PixelisedShark/WROFutureEngineers2024/v-photos/car_bottom.jpg

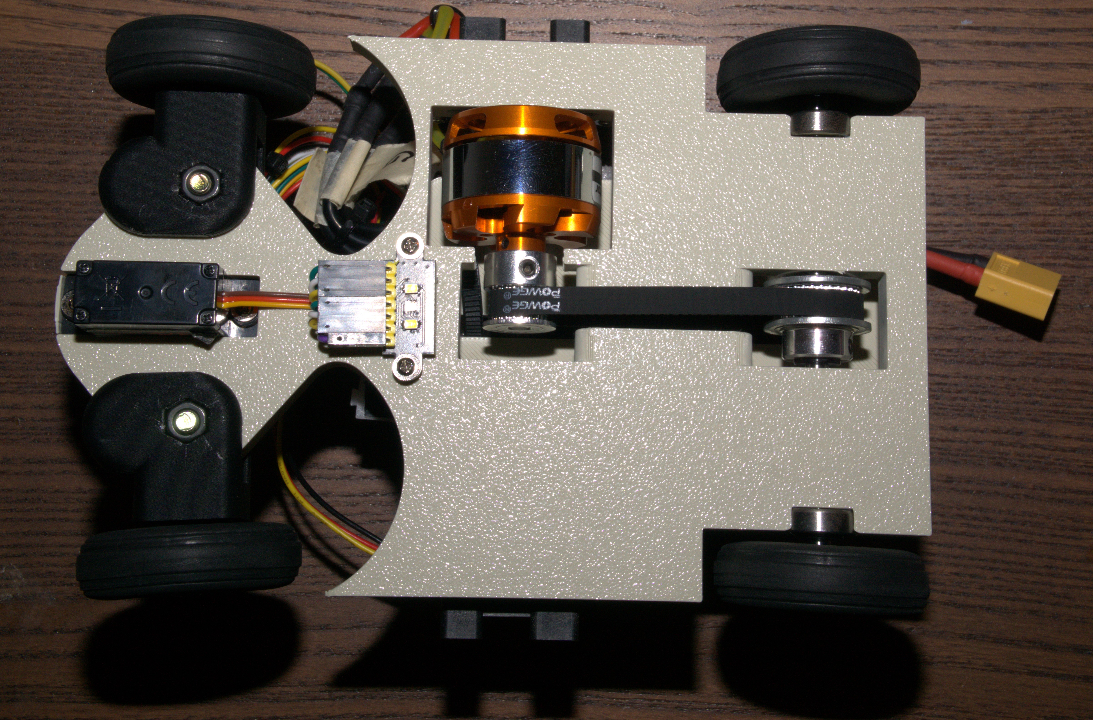
v-photos/car_bottom.jpg
