PixelisedShark/WROFutureEngineers2024/v-photos/car_side2.jpg

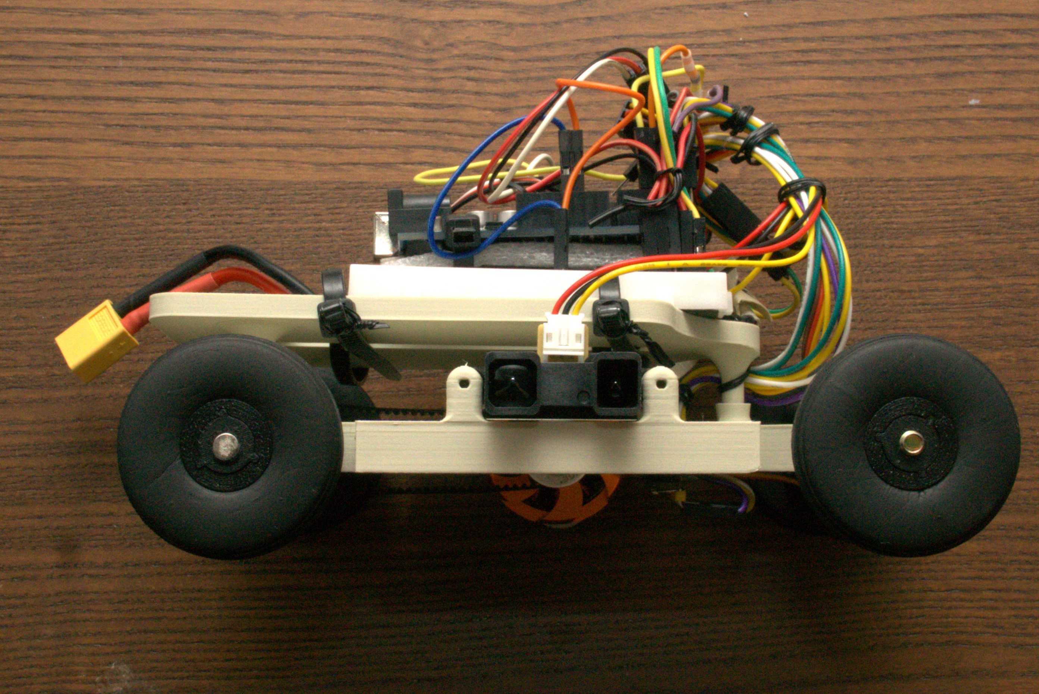
v-photos/car_side2.jpg
