PixelisedShark/WROFutureEngineers2024/README.md

Engineering materials
====

This repository contains engineering materials of a self-driven vehicle's model participating in the WRO Future Engineers competition in the season 2024.

## Content

* `t-photos` contains 2 photos of the team (an official one and one funny photo with all team members)
* `v-photos` contains 6 photos of the vehicle (from every side, from top and bottom)
* `video` contains the video.md file with the link to a video where driving demonstration exists
* `schemes` contains one or several schematic diagrams in form of JPEG, PNG or PDF of the electromechanical components illustrating all the elements (electronic components and motors) used in the vehicle and how they connect to each other.
* `src` contains code of control software for all components which were programmed to participate in the competition
* `models` is for the files for models used by 3D printers, laser cutting machines and CNC machines to produce the vehicle elements. If there is nothing to add to this location, the directory can be removed.
* `other` is for other files which can be used to understand how to prepare the vehicle for the competition. It may include documentation how to connect to a SBC/SBM and upload files there, datasets, hardware specifications, communication protocols descriptions etc. If there is nothing to add to this location, the directory can be removed.

## Introduction

Group Members:
Jing Wei (builder)
Chandler (coder)
Dhevash (coder)

Hello, Viewer!

We are a group of students from Yuan Ching Secondary School. This repository contains a collection of our work from the past year. All models and files here are open source, so you’re welcome to use them as inspiration, adapt them to your needs, or enhance them further.

We hope that by sharing our work, we can contribute to the broader community and assist others in their projects.

Happy exploring!

Electronics used
   *husky lense
   *brushless DC motor
   *Sharp IR sensors
   *Colour Sensor 
   *servo

Documentation of building, prototyping and assembly is under other files. complied as a PDF
