PixelisedShark/WROFutureEngineers2024/v-photos/car_front.jpg

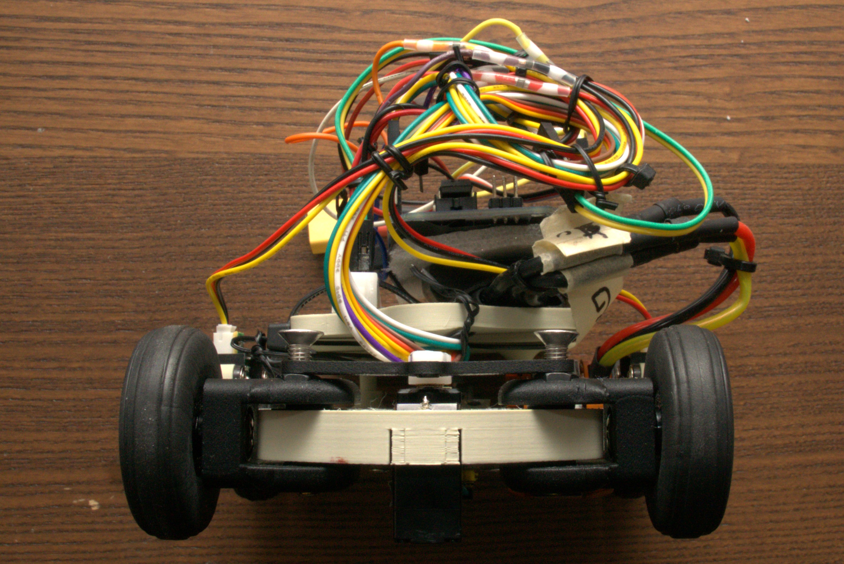
v-photos/car_front.jpg
