PixelisedShark/WROFutureEngineers2024/v-photos/car_side1.jpg

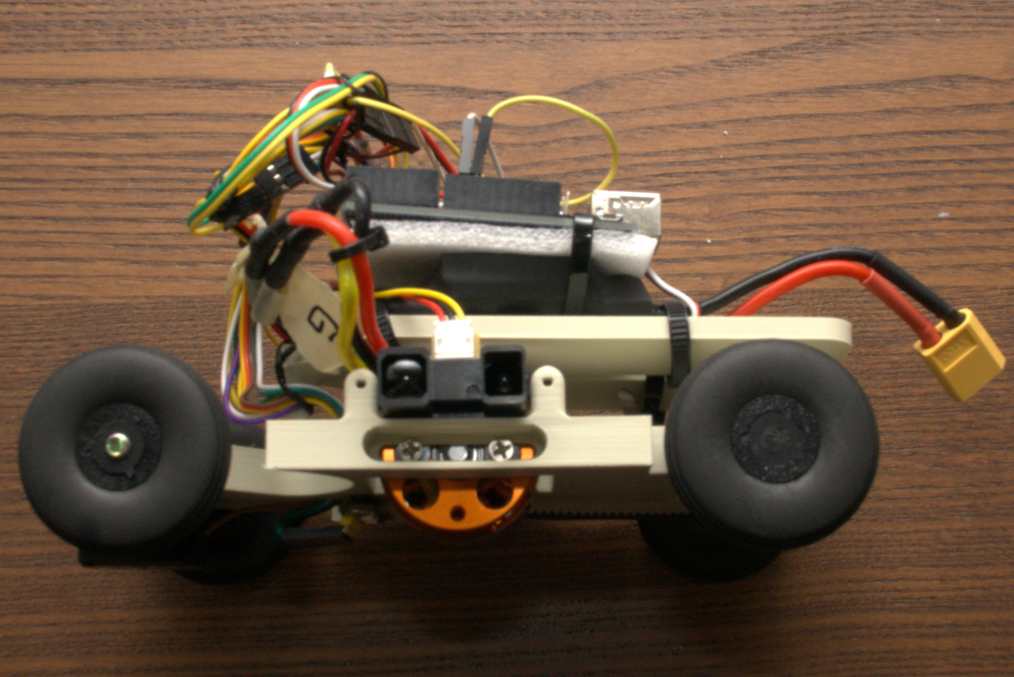
v-photos/car_side1.jpg
