PixelisedShark/WROFutureEngineers2024/v-photos/car_top.jpg

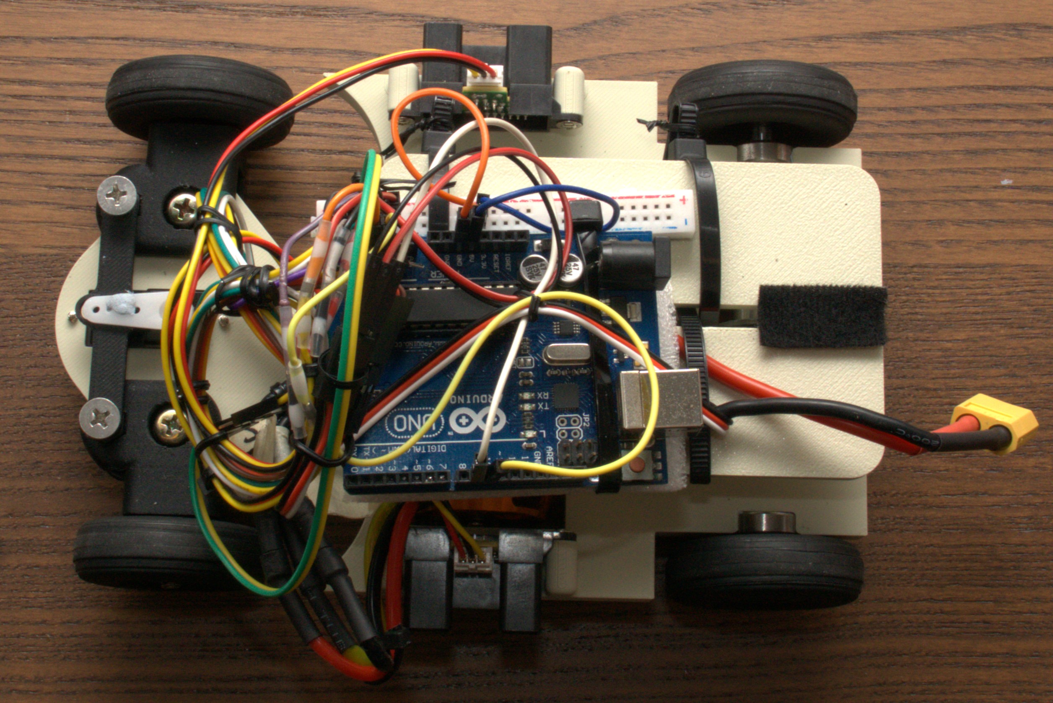
v-photos/car_top.jpg
