PixelisedShark/WROFutureEngineers2024/models/CrAB v24.stl

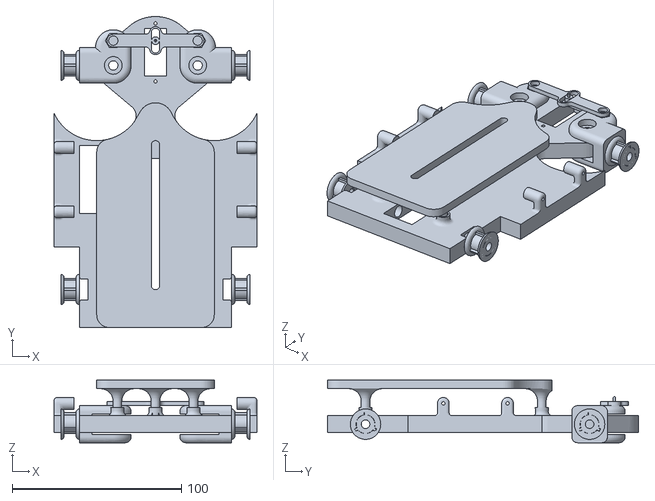
[picture p11: CAD file, 2024-08-26]
models/CrAB v24.stl
120.0 x 183.9 x 37.0
