PixelisedShark/WROFutureEngineers2024/(list of files, cad)

Other CAD files:
models/CrAB v24.f3d
