PixelisedShark/WROFutureEngineers2024/schemes/WRO_futureengineers_merchanicalSchematics.pdf

183.93 | 10 | 183.93 120

# 10 Car scale 1:1.5

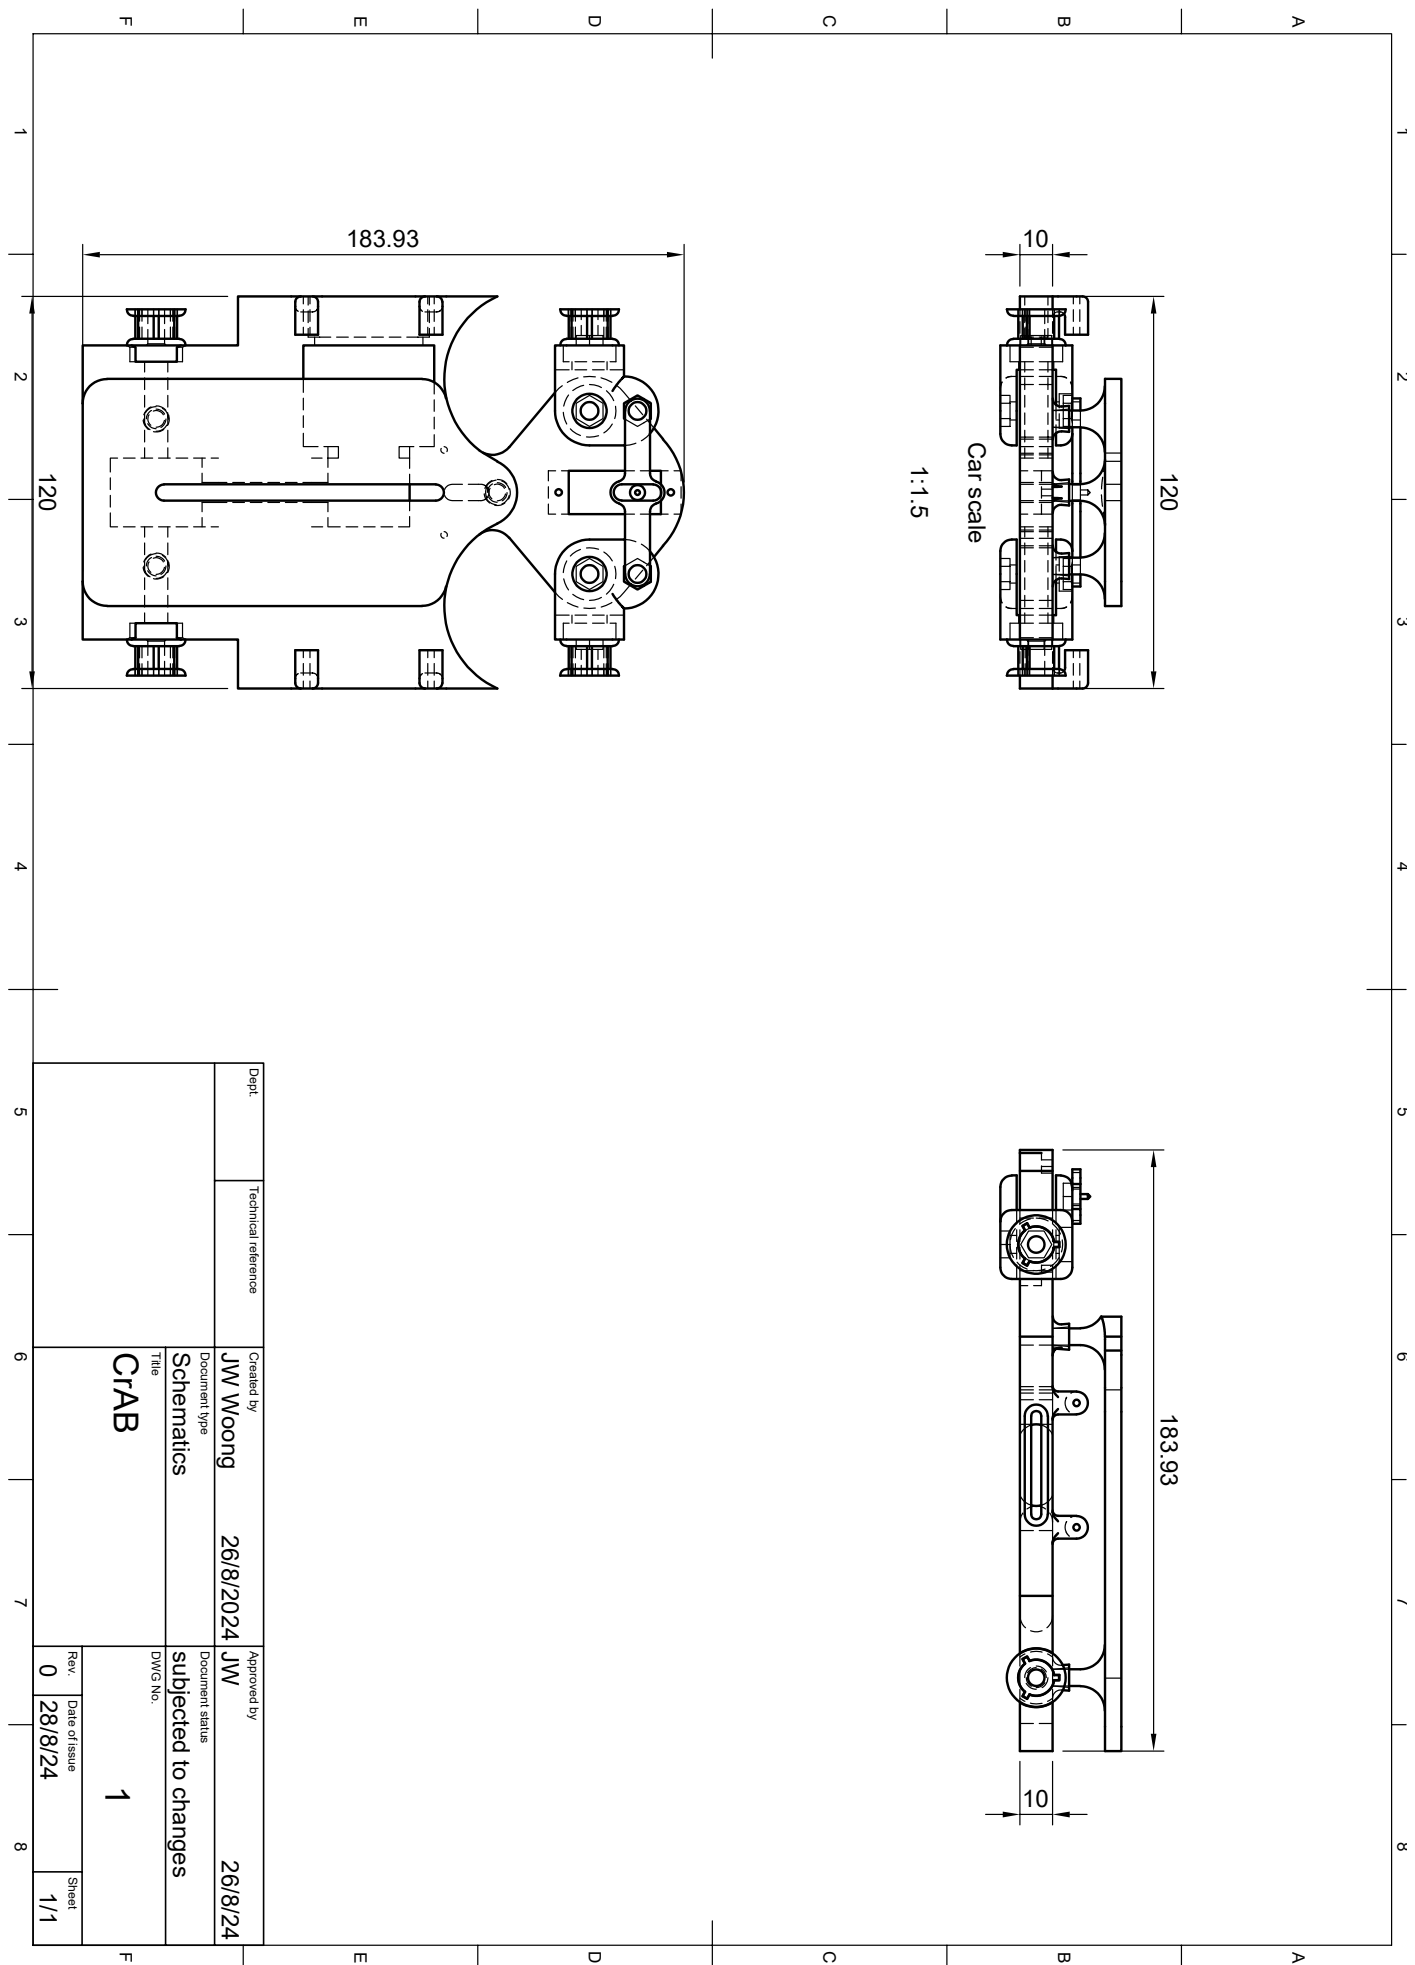
[picture p13: page 1]

1 A 2 3 4 5 6 7 8 1 2 3 4 5 6 7 8 FEDCB FEDCBA Dept. Technical reference Created by Approved by Title DWG No. Document type Document status Rev. Date of issue Sheet 28/8/24 0subjected to changes Schematics 26/8/24 26/8/2024 1/1 1 CrAB JW JW Woong 120
