PixelisedShark/WROFutureEngineers2024/(commit log)

2024-08-28 Create Steering_CodeV1
2024-08-28 Create Steering_codeV2
